bbx10/nanohab/(threads)

Thread 1 (2016-12-20):

Stack Error

boaschti, 2016-12-20:
Hello,

i use the code with WEMOS D1 mini.

I get this output on com port:

Do you have any idea?
A second gateway with the same hardware had the same mistake. But now it works and i don't know why....

RFM69 WiFi Gateway
Exception
eeprom_setup
Factory reset

Exception (28):
epc1=0x4000bf0e epc2=0x00000000 epc3=0x00000000 excvaddr=0x00000000 depc=0x00000000

ctx: cont
sp: 3fff1db0 end: 3fff1fb0 offset: 01a0

>>>stack>>>
3fff1f50:  3ffe8b24 3fff33fc 3fff0c88 40203062
3fff1f60:  00000000 00000000 00000000 4020e5ac
3fff1f70:  3fffdad0 00000000 3fff0ec8 40203876
3fff1f80:  00000000 00000000 00000000 feefeffe
3fff1f90:  feefeffe feefeffe 3fff0f7d 4020f90c
3fff1fa0:  feefeffe feefeffe 3fff0f90 40100718
<<<stack<<<

!
 J­J!!ŠH…
         1Œ8ø½ÖˆK¥SˆˆkH

                       ÊX
                         ÌŸÖŒ˜œ!HN=˜ùHN=èZM!Šø¯

boaschti, 2016-12-20:
It is the line "strcpy(pGC->mqttclientname, WiFi.hostname().c_str());"in funktion "void eeprom_setup()" which generate the Exception (28).

Thread 3 (2016-12-20):

SPI don't work

boaschti, 2016-12-20:
https://github.com/esp8266/Arduino/issues/2765

Thread 6 (2018-02-23):

Can't find G0 pin.

SuoaJ, 2018-02-23:
Hi. I noticed you have a pin called "G0" for the RFM69 under the "Hook up" section in readme for the Nanohab. Is this correct? I cannot find a pin called G0 on my RFM69 breakout board? Should it have been D0? Many thanks.

SuoaJ, 2018-02-23:
Don't bother. I just realised that you are using the Adafruit RFM69 board and the I/O pins are labeled G0, G1, G2, etc, etc.

Thread 7 (2018-04-19):

Stack Error

RattyMaHatty, 2018-04-19:
Hi,

Firstly please let me say thanks for creating this project and any support you may be able to give!

My problem;

I get the following looping stack error on my ESP-12F:

-----------------------------------------------------
RFM69 WiFi Gateway
External System
1
2
3
4
Factory reset
5
6
7
8
9
10

Exception (28):
epc1=0x40213522 epc2=0x00000000 epc3=0x00000000 excvaddr=0x00000000 depc=0x00000000

ctx: cont
sp: 3fff1700 end: 3fff1910 offset: 01a0

>>>stack>>>
3fff18a0:  7fffffff 3fff04a4 3fff0824 40203136
3fff18b0:  00000000 00000000 00000000 40100690
3fff18c0:  0001c200 0000001c 3fff0824 3fff08e4
3fff18d0:  3fffdad0 00000000 3fff0824 402039a4
3fff18e0:  00000000 00000000 00000000 feefeffe
3fff18f0:  feefeffe feefeffe 3fff08dd 4021118c
3fff1900:  feefeffe feefeffe 3fff08f0 40100710
<<<stack<<<

 ets Jan  8 2013,rst cause:2, boot mode:(3,6)

load 0x4010f000, len 1384, room 16
tail 8
chksum 0x2d
csum 0x2d
v614f7c32
~ld

-----------------------------------------------------

I've successfully uploaded the 2 of the example (esp8266) programs and they function as expected but I get stuck in the above loop with yours.

Now you maybe wondering what those 1,2,3,4,5,etc are in the serial port output, it's my basic debugging. (my edit of your eeprom_setup() function code below)

-----------------------------------------------------
void eeprom_setup() {
  Serial.println("1");
  EEPROM.begin(4096);
  Serial.println("2");
  pGC = (struct _GLOBAL_CONFIG *)EEPROM.getDataPtr();
  Serial.println("3");
  // if checksum bad init GC else use GC values
  if (gc_checksum() != pGC->checksum) {
    Serial.println("4");
    Serial.println("Factory reset");
    Serial.println("5");
    memset(pGC, 0, sizeof(*pGC));
    Serial.println("6");
    strcpy_P(pGC->encryptkey, ENCRYPTKEY);
    Serial.println("7");
    strcpy_P(pGC->rfmapname, RFM69AP_NAME);
    Serial.println("8");
    strcpy_P(pGC->mqttbroker, MQTT_BROKER);
    Serial.println("9");
    strcpy_P(pGC->mdnsname, MDNS_NAME);
    Serial.println("10");
    strcpy(pGC->mqttclientname, WiFi.hostname().c_str());
    Serial.println("11");
    pGC->networkid = NETWORKID;
    Serial.println("12");
    pGC->nodeid = NODEID;
    Serial.println("13");
    pGC->powerlevel = ((IS_RFM69HCW)?0x80:0x00) | POWER_LEVEL;
    Serial.println("14");
    pGC->rfmfrequency = FREQUENCY;
    Serial.println("15");
    pGC->checksum = gc_checksum();
    Serial.println("16");
    EEPROM.commit();
    Serial.println("17");
  }
}

-----------------------------------------------------

It seems the problem is with:

strcpy(pGC->mqttclientname, WiFi.hostname().c_str());

Do you have any thoughts??

Thanks again for any time you can spend on this!

Matt

RattyMaHatty, 2018-04-24:
Hi,

Resolved:

Added the bold italic line to //Default values;

// Default values
const char PROGMEM ENCRYPTKEY[] = "sampleEncryptKey";
const char PROGMEM MDNS_NAME[] = "rfm69gw1";
const char PROGMEM MQTT_BROKER[] = "raspi2";
const char PROGMEM RFM69AP_NAME[] = "RFM69-AP";
**_const char PROGMEM MQTT_CLIENT[] = "RFM69V1";_**

And made the change to the bold italic line below;

void eeprom_setup() {
  EEPROM.begin(4096);
  pGC = (struct _GLOBAL_CONFIG *)EEPROM.getDataPtr();
  // if checksum bad init GC else use GC values
    if (gc_checksum() != pGC->checksum) {
    Serial.println("Factory reset");
    memset(pGC, 0, sizeof(*pGC));
    strcpy_P(pGC->encryptkey, ENCRYPTKEY);
    strcpy_P(pGC->rfmapname, RFM69AP_NAME);
    strcpy_P(pGC->mqttbroker, MQTT_BROKER);
    strcpy_P(pGC->mdnsname, MDNS_NAME);
    **_strcpy(pGC->mqttclientname, MQTT_CLIENT);_**
    pGC->networkid = NETWORKID;
    pGC->nodeid = NODEID;
    pGC->powerlevel = ((IS_RFM69HCW)?0x80:0x00) | POWER_LEVEL;
    pGC->rfmfrequency = FREQUENCY;
    pGC->checksum = gc_checksum();
    EEPROM.commit();
  }
}

I hope that helps if anyone else is stuck here..

Closed 2018-04-24.

Thread 8 (2019-03-07):

Problem with high power mode

LordDuplo, 2019-03-07:
Hi,

i have a problem when switching IS_RFM69HCW true.

When the option is set to false and i open the serial monitor all works fine.
I can see that the arduino pro mini sends the correct values.

But when i switch the option to true the serial output looks strange.
And after a while the arduino crashs.

Do you know why?

My setup is the following:

Gateway: Wemos D1 Mini with RFM69CW
Sender: Arduino Pro Mini 3.3V 8 Mhz with RFM69HW
