bbx10/nanohab/(notices)

Notices in the files:
rfm69gw/rfm69gw.ino:
Copyright Felix Rusu, LowPowerLab.com
Public License as published by the Free Software
Public License along with this program.
